connectionsmuseum/TapeEmulator/converter_board_v1/README.md

Pinout
======

JP1 Pin | JP1 Pin | Direction | Function | Adafruit Pin | SAMD Pin |
  ---   |   ---   |    ---    |   ---    |   ------     |   ----   |
   1    |   +5V   |   Power   |          |              |          |
   2    |   +5V   |   Power   |          |              |          |
   3    |   D22   | FROM_CTTC | MANEN0   |   D22        | PD12     |
   4    |   D23   | FROM_CTTC | WRENAB0  |   D23        | PA15     |
   5    |   D24   | FROM_CTTC | WTA10    |   SCL_1      | PC17     |
   6    |   D25   | FROM_CTTC | WTA00    |   SDA_1      | PC16     |
   7    |   D26   | FROM_CTTC | RTA10    |   PCC_DEN1   | PA12     |
   8    |   D27   |           |          |   PCC_DEN2   | PA13     |
   9    |   D28   | FROM_CTTC | RTA00    |   PCC_CLK    | PA14     |
   10   |   D29   |           |          |   PCC_XCLK   | PB19     |
   11   |   +3V3  |   Power   |          |   PCC_D7     | PA23     |
   12   |   D31   |   TO_CTTC | TTBOTA0  |   PCC_D6     | PA22     |
   13   |   D32   |   TO_CTTC | TTEOTA0  |   PCC_D5     | PA21     |
   14   |   D33   |   TO_CTTC | TTRDY0   |   PCC_D4     | PA20     |
   15   |   D34   | FROM_CTTC | WRDATA   |   PCC_D3     | PA19     |
   16   |   D35   |           |          |   PCC_D2     | PB18     |
   17   |   D36   |   TO_CTTC | RDCLK0   |   PCC_D1     | PA17     |
   18   |   D37   |   TO_CTTC | RDDATA0  |   PCC_D0     | PA16     |
   19   |   D38   |           |          |   PCC_D9     | PB15     |
   20   |   D39   |           |          |   PCC_D8     | PB14     |
   21   |   D40   |   TO_CTTC | DATDET0  |   PCC_D11    | PC13     |
   22   |   D41   |   TO_CTTC | TIMA0    |   PCC_D10    | PC12     |
   23   |   D42   |   TO_CTTC | RWDINGA0 |   PCC_D13    | PC15     |
   24   |   D43   |   TO_CTTC | LPEW0    |   PCC_D12    | PC14     |
   25   |   D44   |   TO_CTTC | CARTWE0  |   D44        | PC11     |
   26   |   D45   |   TO_CTTC | TOR0     |   D45        | PC10     |
   27   |   D46   | FROM_CTTC | TTMSPT0  |   D46        | PC06     |
   28   |   D47   | FROM_CTTC | TTREWC0  |   D47        | PC07     |
   29   |   D48   | FROM_CTTC | TTINIT0  |   D48        | PC04     |
   30   |   D49   | FROM_CTTC | TTSEL0   |   D49        | PC05     |
   31   |   D50   | FROM_CTTC | TTSR0    |   MISO       | PD11     |
   32   |   D51   | FROM_CTTC | TTFR0    |   MOSI       | PD08     |
   33   |   D52   | FROM_CTTC | TTSF0    |   SCK        | PD09     |
   34   |   D53   | FROM_CTTC | TTFF0    |   SS         | PD10     |
   35   |   GND   |  Power    |          |              |          |
   36   |   GND   |  Power    |          |              |          |
