connectionsmuseum/TapeEmulator/scope_1.png

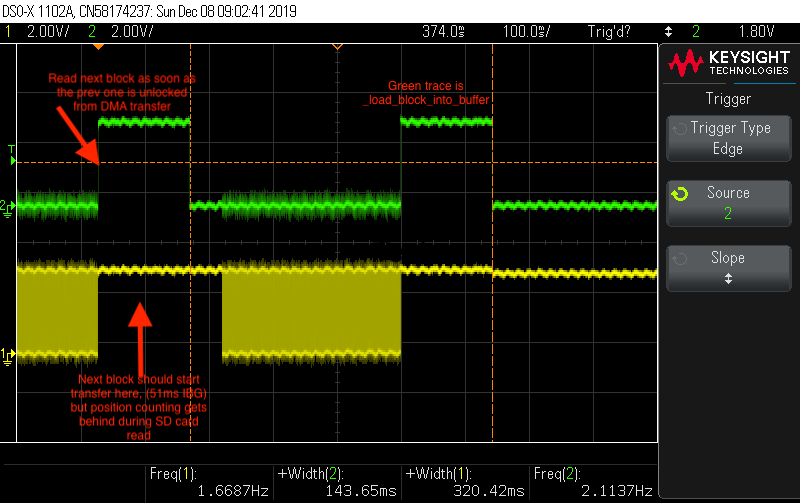
scope_1.png
