connectionsmuseum/TapeEmulator/scope_2.png

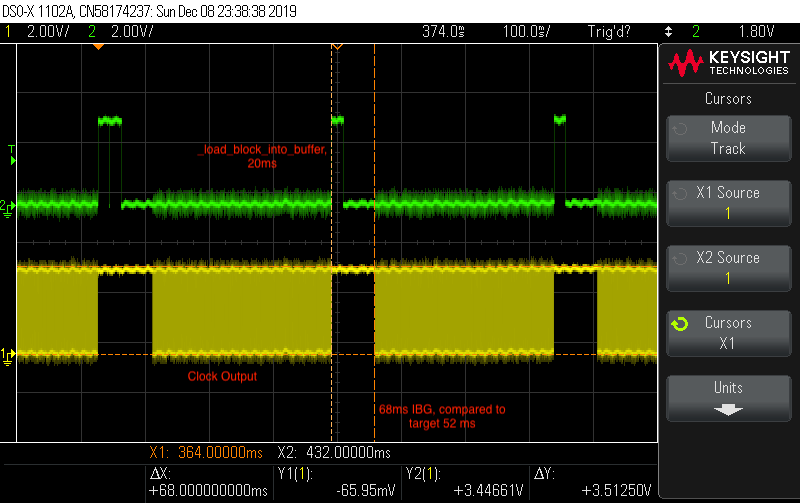
scope_2.png
