connectionsmuseum/TapeEmulator/scope_3.png

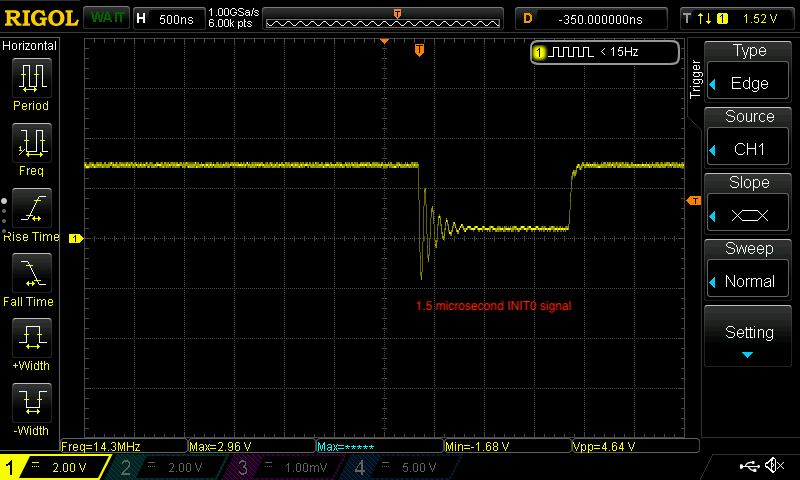
scope_3.png
