connectionsmuseum/TapeEmulator/scope_4.png

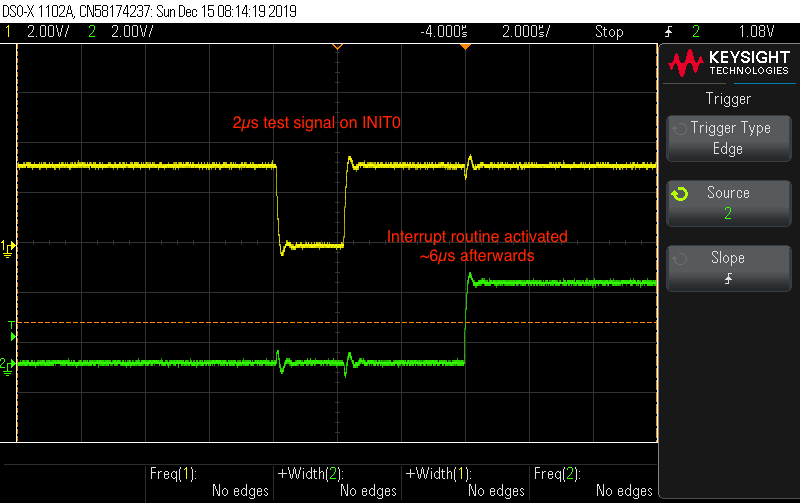
scope_4.png
