connectionsmuseum/TapeEmulator/converter_board_v1/coverter_board_layout.pdf

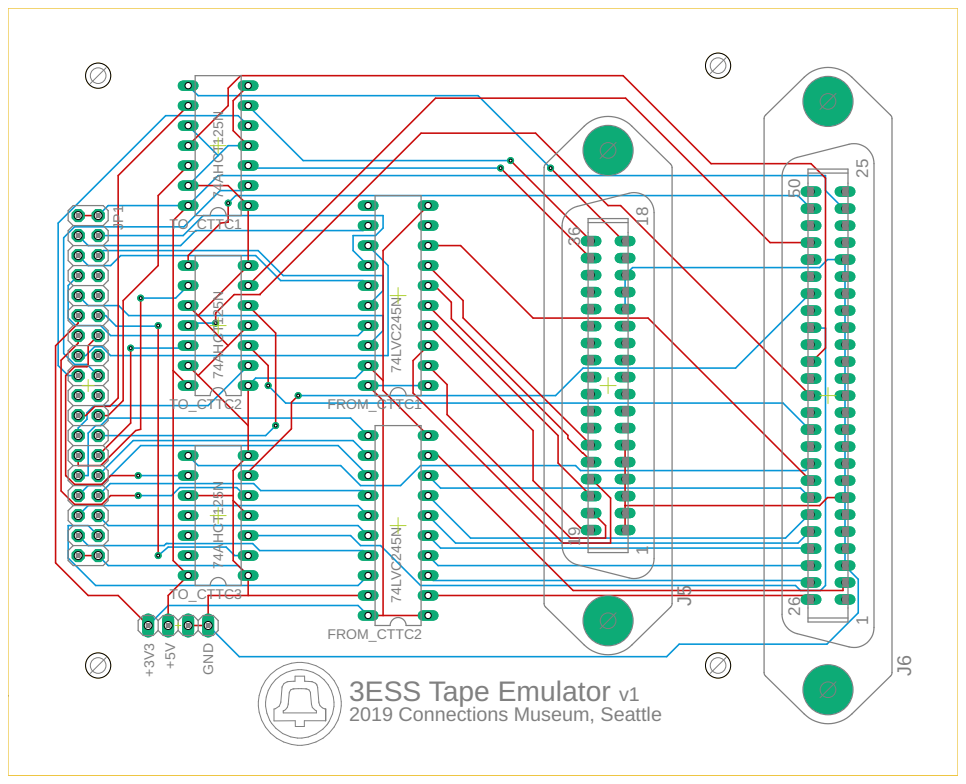
[picture p5: page 1]

+3V3 +5V GND 2019 Connections Museum, Seattle 3ESS Tape Emulator v1 119 18 36 126 25 50 TO_CTTC1 TO_CTTC2 TO_CTTC3 FROM_CTTC1 FROM_CTTC2 J5 J6 JP1 74AHCT125N 74AHCT125N 74AHCT125N 74LVC245N 74LVC245N
