connectionsmuseum/TapeEmulator/converter_board_v1/coverter_schematic.pdf

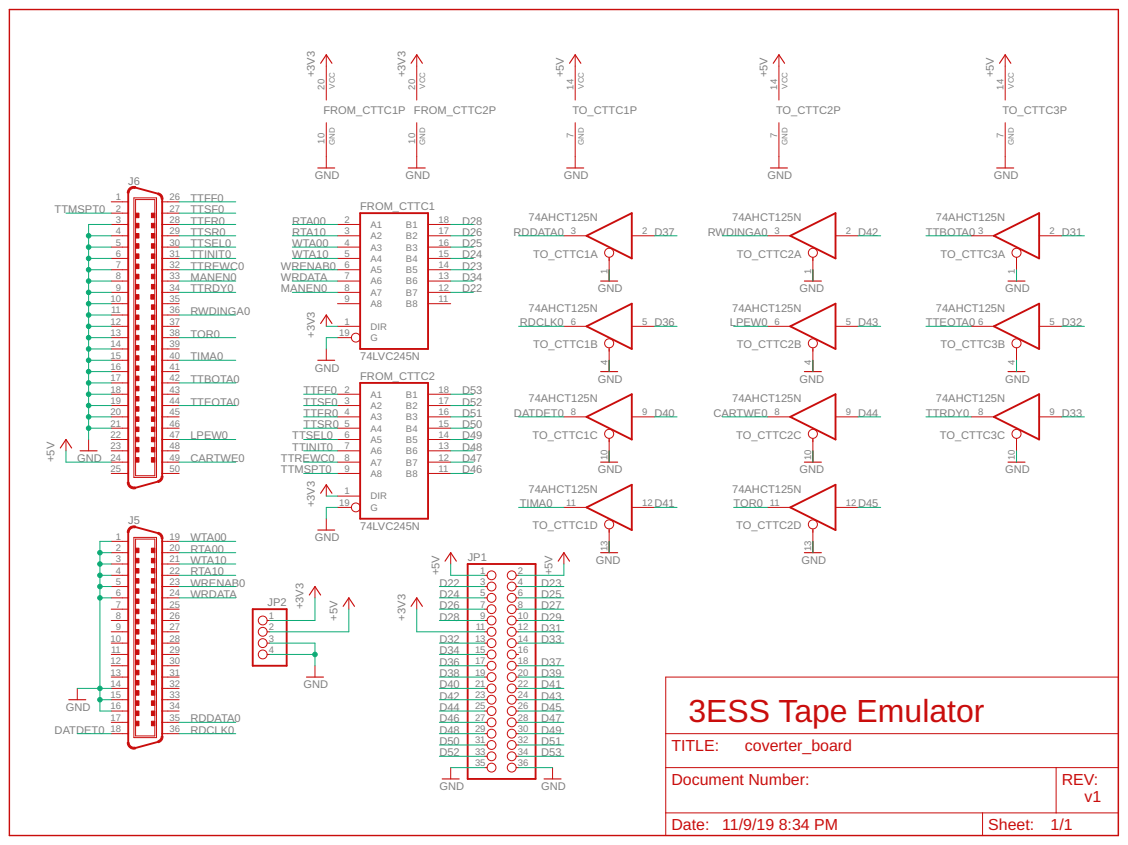
[picture p6: page 1]

Document Number: | REV: v1

Date: 11/9/19 8:34 PM | Sheet: 1/1
