connectionsmuseum/TapeEmulator/converter_board_v1/coverter_board.brd

## EAGLE design converter_board_v1/coverter_board.brd (2019-11-11)

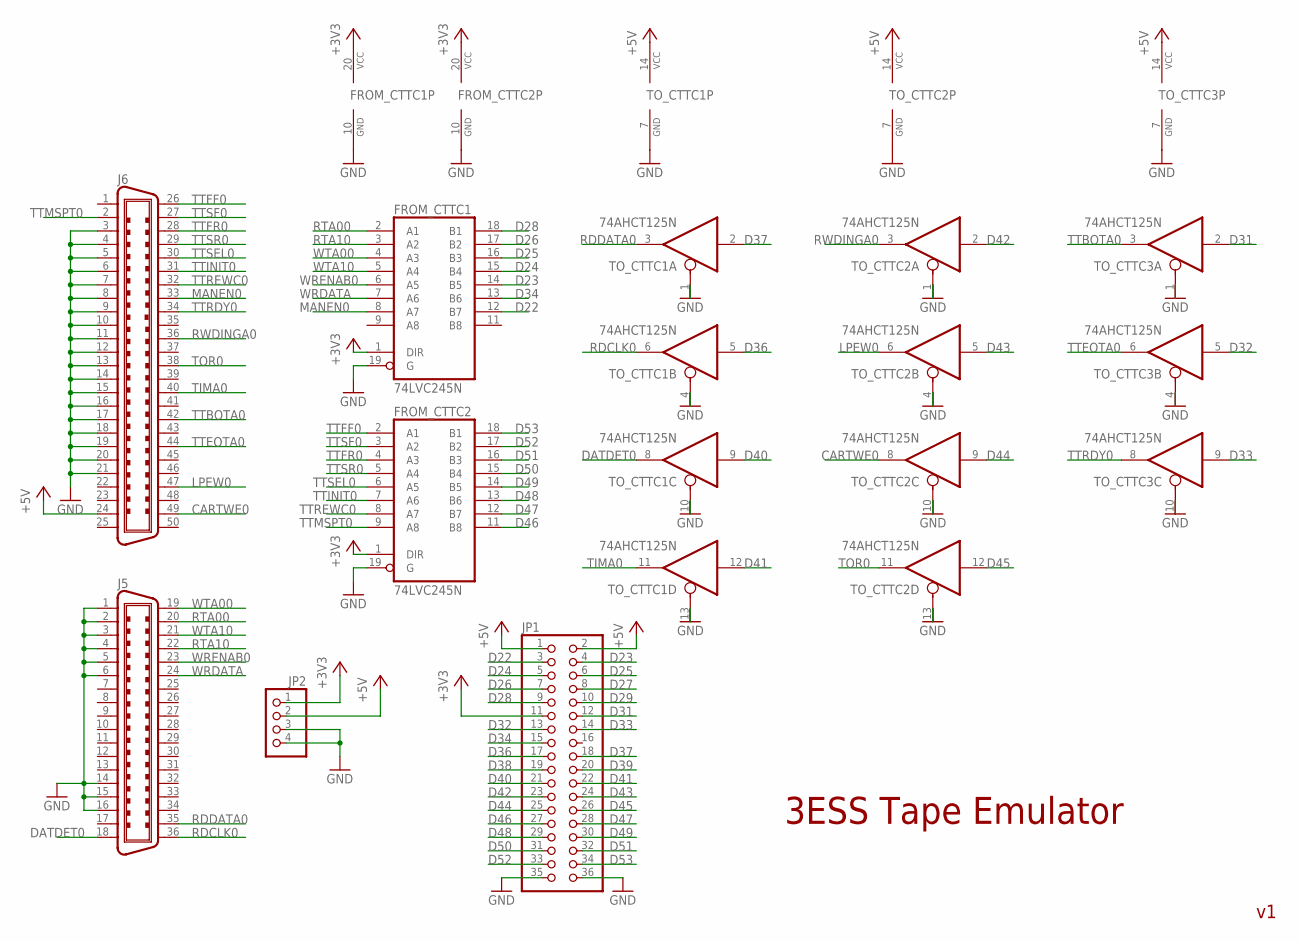
[picture p7: schematic coverter_board.sch]

Parts:
FROM_CTTC1, FROM_CTTC2: 74LVC245N; DIL20
J5: C36V; 36V
J6: C50V; 50V
JP1: PINHD-2X18; 2X18
JP2: PINHD-1X4; 1X04
TO_CTTC1, TO_CTTC2, TO_CTTC3: 74AHCT125N; DIL14

Connections:
+3V3: FROM_CTTC1.1 (DIR), FROM_CTTC1.20 (VCC), FROM_CTTC2.1 (DIR), FROM_CTTC2.20 (VCC), JP1.11, JP2.1
+5V: J6.24, JP1.1, JP1.2, JP2.2, TO_CTTC1.14 (VCC), TO_CTTC2.14 (VCC), TO_CTTC3.14 (VCC)
CARTWE0: J6.49, TO_CTTC2.8 (O)
D22: FROM_CTTC1.12 (B7), JP1.3
D23: FROM_CTTC1.14 (B5), JP1.4
D24: FROM_CTTC1.15 (B4), JP1.5
D25: FROM_CTTC1.16 (B3), JP1.6
D26: FROM_CTTC1.17 (B2), JP1.7
D27: JP1.8
D28: FROM_CTTC1.18 (B1), JP1.9
D29: JP1.10
D31: JP1.12, TO_CTTC3.2 (I)
D32: JP1.13, TO_CTTC3.5 (I)
D33: JP1.14, TO_CTTC3.9 (I)
D34: FROM_CTTC1.13 (B6), JP1.15
D36: JP1.17, TO_CTTC1.5 (I)
D37: JP1.18, TO_CTTC1.2 (I)
D38: JP1.19
D39: JP1.20
D40: JP1.21, TO_CTTC1.9 (I)
D41: JP1.22, TO_CTTC1.12 (I)
D42: JP1.23, TO_CTTC2.2 (I)
D43: JP1.24, TO_CTTC2.5 (I)
D44: JP1.25, TO_CTTC2.9 (I)
D45: JP1.26, TO_CTTC2.12 (I)
D46: FROM_CTTC2.11 (B8), JP1.27
D47: FROM_CTTC2.12 (B7), JP1.28
D48: FROM_CTTC2.13 (B6), JP1.29
D49: FROM_CTTC2.14 (B5), JP1.30
D50: FROM_CTTC2.15 (B4), JP1.31
D51: FROM_CTTC2.16 (B3), JP1.32
D52: FROM_CTTC2.17 (B2), JP1.33
D53: FROM_CTTC2.18 (B1), JP1.34
DATDET0: J5.18, TO_CTTC1.8 (O)
GND: FROM_CTTC1.10 (GND), FROM_CTTC1.19 (G), FROM_CTTC2.10 (GND), FROM_CTTC2.19 (G), J5.1, J5.2, J5.3, J5.4, J5.5, J5.6, J5.14, J5.15, J5.16, J6.3, J6.4, J6.5, J6.6, J6.7, J6.8, J6.9, J6.10, J6.11, J6.12, J6.13, J6.14, J6.15, J6.16, J6.17, J6.18, J6.19, J6.20, J6.21, JP1.35, JP1.36, JP2.3, JP2.4, TO_CTTC1.1 (OE), TO_CTTC1.4 (OE), TO_CTTC1.7 (GND), TO_CTTC1.10 (OE), TO_CTTC1.13 (OE), TO_CTTC2.1 (OE), TO_CTTC2.4 (OE), TO_CTTC2.7 (GND), TO_CTTC2.10 (OE), TO_CTTC2.13 (OE), TO_CTTC3.1 (OE), TO_CTTC3.4 (OE), TO_CTTC3.7 (GND), TO_CTTC3.10 (OE)
LPEW0: J6.47, TO_CTTC2.6 (O)
MANEN0: FROM_CTTC1.8 (A7), J6.33
RDCLK0: J5.36, TO_CTTC1.6 (O)
RDDATA0: J5.35, TO_CTTC1.3 (O)
RTA00: FROM_CTTC1.2 (A1), J5.20
RTA10: FROM_CTTC1.3 (A2), J5.22
RWDINGA0: J6.36, TO_CTTC2.3 (O)
TIMA0: J6.40, TO_CTTC1.11 (O)
TOR0: J6.38, TO_CTTC2.11 (O)
TTBOTA0: J6.42, TO_CTTC3.3 (O)
TTEOTA0: J6.44, TO_CTTC3.6 (O)
TTFF0: FROM_CTTC2.2 (A1), J6.26
TTFR0: FROM_CTTC2.4 (A3), J6.28
TTINIT0: FROM_CTTC2.7 (A6), J6.31
TTMSPT0: FROM_CTTC2.9 (A8), J6.2
TTRDY0: J6.34, TO_CTTC3.8 (O)
TTREWC0: FROM_CTTC2.8 (A7), J6.32
TTSEL0: FROM_CTTC2.6 (A5), J6.30
TTSF0: FROM_CTTC2.3 (A2), J6.27
TTSR0: FROM_CTTC2.5 (A4), J6.29
WRDATA: FROM_CTTC1.7 (A6), J5.24
WRENAB0: FROM_CTTC1.6 (A5), J5.23
WTA00: FROM_CTTC1.4 (A3), J5.19
WTA10: FROM_CTTC1.5 (A4), J5.21

Notes on the sheet:
3ESS Tape Emulator

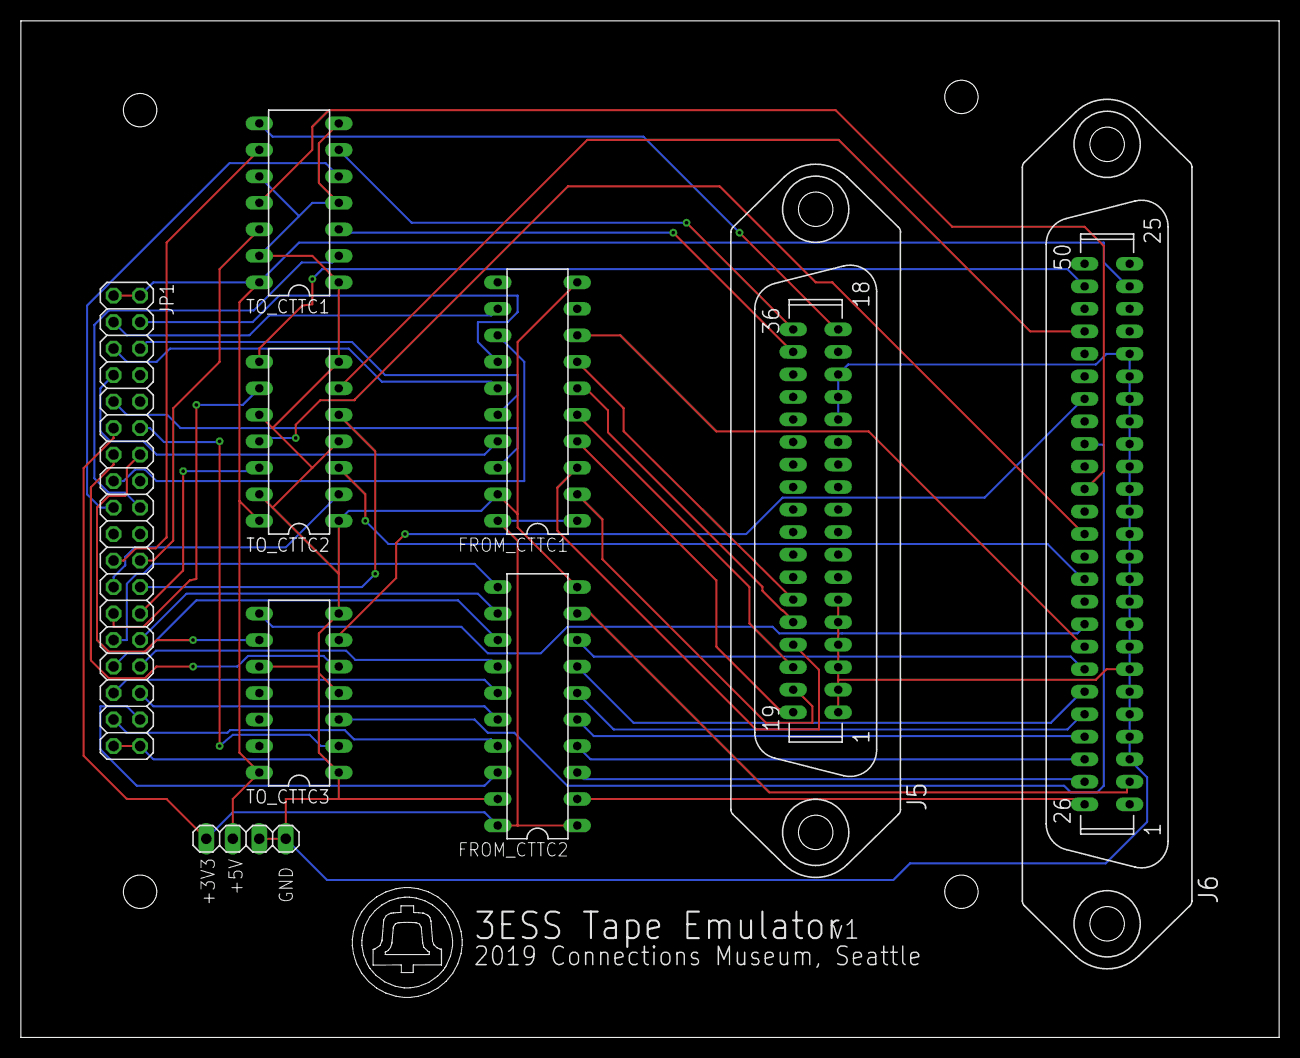
[picture p8: board coverter_board.brd from above]

Board: 2 copper layers, 120.6 x 97.5 mm, 9 parts (0 on the bottom side), 55 nets.
