connectionsmuseum/TapeEmulator/driver_init.h

/*
 * Code generated from Atmel Start.
 *
 * This file will be overwritten when reconfiguring your Atmel Start project.
 * Please copy examples or other code you want to keep to a separate file
 * to avoid losing it when reconfiguring.
 */
#ifndef DRIVER_INIT_INCLUDED
#define DRIVER_INIT_INCLUDED

#include "atmel_start_pins.h"

#ifdef __cplusplus
extern "C" {
#endif

#include <hal_atomic.h>
#include <hal_delay.h>
#include <hal_gpio.h>
#include <hal_init.h>
#include <hal_io.h>
#include <hal_sleep.h>

#include <hal_ext_irq.h>

#include <hal_evsys.h>

#include <hal_timer.h>
#include <hal_spi_m_sync.h>

#include <hal_spi_m_dma.h>

#include <hal_mci_sync.h>
#include <hal_timer.h>
#include <hpl_tc_base.h>

#include "hal_usb_device.h"

extern struct timer_descriptor      TIMER_0;
extern struct spi_m_sync_descriptor SPI_0;

extern struct spi_m_dma_descriptor SPI_1;
extern struct spi_m_sync_descriptor SPI_2;

extern struct mci_sync_desc IO_BUS;

extern struct timer_descriptor TIMER_1;

void SPI_0_PORT_init(void);
void SPI_0_CLOCK_init(void);
void SPI_0_init(void);

void SPI_1_PORT_init(void);
void SPI_1_CLOCK_init(void);
void SPI_1_init(void);

void SPI_2_PORT_init(void);
void SPI_2_CLOCK_init(void);
void SPI_2_init(void);

void IO_BUS_PORT_init(void);
void IO_BUS_CLOCK_init(void);
void IO_BUS_init(void);

void USB_0_CLOCK_init(void);
void USB_0_init(void);

/**
 * \brief Perform system initialization, initialize pins and clocks for
 * peripherals
 */
void system_init(void);

#ifdef __cplusplus
}
#endif
#endif // DRIVER_INIT_INCLUDED
