connectionsmuseum/TapeEmulator/(commit log)

2019-08-07 Trying to fix some clock bugs. Still not 120MHz.
    [main.c]
2019-08-17 LED blinking now works via timer.
2019-08-19 Pull SPI DMA driver from atmel start.
2019-08-20 Rearrange code, separate LED handling file.
2019-09-12 DMA transfer partially working, but only sends two bytes.
2019-09-12 DMA fixed; writes out full message.
2019-09-21 Checkpoint, added TC-based timer code from ATStart.
2019-09-21 Try to get some timer ticking.
2019-09-21 Timing is working correctly at 1s and 2.5ms, internal OSC32.
    [main.c]
2019-09-27 Put volts on D10.
2019-11-11 First version of the interface board.
    [coverter_board.brd, coverter_board.sch]
2019-11-21 Update pins for converter board v1.
2019-11-23 Fill in the details on tape motion, current block calculations.
2019-11-24 checkpoint. Not working properly.
    [driver_init.c, main.c]
2019-11-30 Break out transfer code. Move all work out of interrupt context.
2019-12-02 Fix multi-block reads from SD card.
    [block_transfer.c]
2019-12-07 Fix output bitrate, and byte-swap the input files.
    Switched SERCOM_1 to use GCLK4, and set GCLK4 to run at 12MHz. With the
    SERCOM at 48MHz, the divider doesn't have enough range to get the output
    bitrate down to the 48kHz we need, so slowing down the SERCOM clock
    makes it fit more comfortably.
    [block_transfer.c]
2019-12-08 Fix some bugs for sequential block reads.
    [block_transfer.c, main.c]
2019-12-15 Handle INIT0 with an interrupt.
2019-12-15 Scope traces from debugging.
2020-01-04 Fix bugs in early warning holes and data detect.
    [block_transfer.c, main.c]
